JoeShi/ki-board/docs/ESP32_5SCREEN_V0.1.pdf

## J111.25_9P

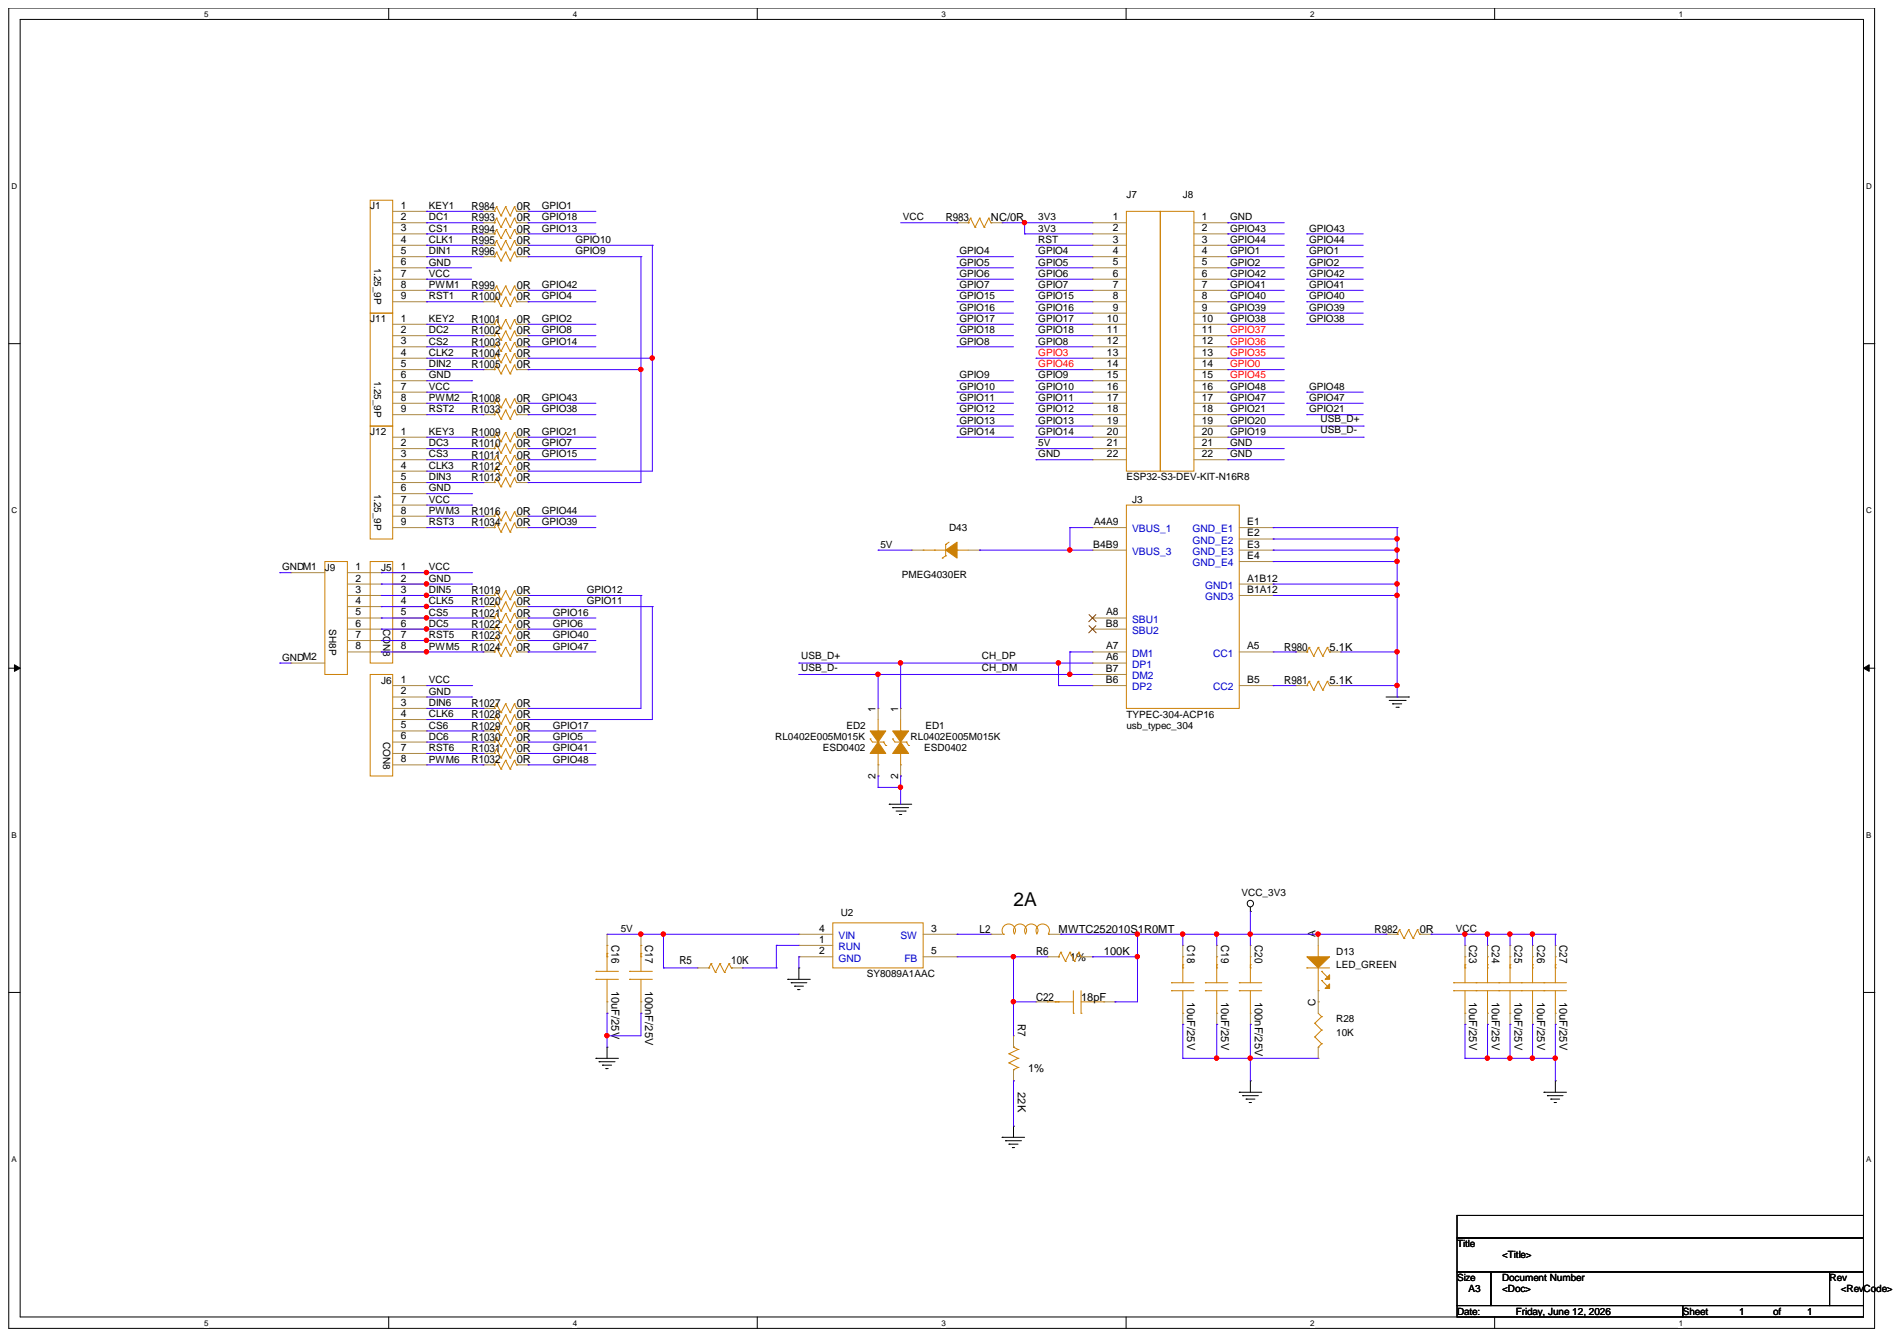
[picture p1: page 1]
