JoeShi/ki-board/(commit log)

2026-06-09 Initial commit: Kiro shortcut keyboard firmware
    ESP32-C6 BLE HID keyboard with 4 screen-keys, rotary encoder, and web config.
    - Modules: keymap/buttons/encoder/ble_hid/display/webconfig
    - BLE HID via HijelHID_BLEKeyboard (NimBLE), encoder via RotaryEncoderPCNT
    - Display via Arduino_GFX (ST7735), web config via ESPAsyncWebServer + NVS
    - Includes docs (hardware bring-up guide, tech glossary) and steering notes
    [default_16MB.csv]
2026-06-09 Add PWM backlight dimming for displays
    - BL pin (GPIO3) driven via LEDC PWM instead of on/off, reduces power and eye strain
    - displaySetBacklight/displayGetBacklight API, configurable freq/resolution/default in config.h
2026-06-13 切换至 USB HID + 圆屏表情动画系统
    通信方案
    - 从 BLE HID 切换为 USB HID (Arduino 内置 USB.h + USBHIDKeyboard.h)
    - 更可靠地触发 macOS 语音输入(双击 Control)等系统级快捷键
    - BLE 代码(ble_hid.*)保留为备用方案
    - 文档对齐: README / design-decisions / project-overview / 硬件调试指南
    圆屏表情
    - 新增 idle / wait / work 三套表情, 各 40 帧 RGB565 @ 4fps, 120x120
    - 圆屏(GC9D01)居中播放, 白色内容显示在黑底上
    - scripts/generate_expressions.py 固化生成管线(ffmpeg 裁切 + region-aware 处理)
    其他
    - 分区表 default_16MB.csv 扩大 app 分区至 8MB(移除 OTA)以容纳表情数据
    - .gitignore 忽略表情中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
    [default_16MB.csv]
2026-06-13 Update firmware display wiring and docs
2026-06-13 Fix ESP32-S3 board target and LCD test
    [test_round_lcd.cpp]
2026-06-13 Add Kiro agent board integration
2026-06-13 Refine agent keyboard interaction flow
2026-06-16 feat: add USB auto-discovery to kiro_board_hook.py and custom USB descriptors
    - Add discover_serial_port() function that matches VID=0x303A, PID=0x1001,
    and product string containing 'ki-board' (case-insensitive)
    - Implement port resolution priority chain:
    1. --serial-port CLI arg
    2. KIRO_BOARD_PORT environment variable
    3. Auto-discovery via serial.tools.list_ports
    4. Fallback to stdout
    - Print diagnostic message to stderr when auto-discovery finds a port
    - Add -DUSB_PRODUCT and -DUSB_MANUFACTURER build flags to [env:esp32-s3]
    so the ESP32-S3 USB CDC reports as 'ki-board' by 'Kiro'
2026-06-16 docs: update documentation to reflect zero-config USB auto-discovery
    - Remove --serial-port from docs/kiro-cli-hooks.example.json
    - Add section 8.3 '自动发现串口' to kiro-agent-status-sync.md
    - Update command examples in sections 6, 7 to show zero-config usage
    - Update AGENTS.md hook integration section with auto-discovery info
    - Update README.md hook configuration section for zero-config
2026-06-16 fix: add multi-board warning and pyserial import hint in discover_serial_port()
    Address review feedback:
    - Issue #1: Emit stderr warning when multiple ki-board devices are found
    - Issue #2: Print diagnostic hint when pyserial import fails instead of
    silently returning None
    [kiro_board_hook.py]
2026-06-20 feat: companion app + USB/BLE pairing & board GATT comms
    Companion (Tauri):
    - USB CDC + BLE GATT bridge to the board, Doubao voice console, keymap editor, firmware flash.
    - Device page redesign: pick USB (plug-and-play) or Bluetooth; pairing only under Bluetooth, auto-connects the bound board (no manual device picking).
    - Application-level pairing/auth: token stored in OS keychain; auth sent on BLE connect; Pair/Forget flow with on-board numeric-comparison confirm.
    - Fix: keep BLE Manager/Adapter alive for the connection lifetime so CoreBluetooth notifications are delivered; truthful write logging; 5s heartbeat; suppress heartbeat log spam.
    Firmware:
    - Custom Kiro BLE GATT service with per-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
    [agent_registry.cpp, agent_registry.h, ble_gatt_comm.cpp, ble_gatt_comm.h, kiro_board_hook.py]
2026-06-20 feat: NimBLE migration, BLE HID keyboard, HID output routing via companion
    - Migrated custom Kiro GATT service from Bluedroid to NimBLE (shared server singleton).
    - Added BLE HID keyboard (HijelHID_BLEKeyboard) on the same NimBLE server.
    - HID only discoverable during pairing mode (left+right 3s); hidden otherwise.
    - Pairing confirm (●) now always exits pairing window even without companion request.
    - HID output routing: companion app configures USB or BLE HID via set_hid_output command; board persists choice in NVS.
    - Device page: mode switch syncs HID output to board; pairing code shown inline via status polling.
    - Added clear_logs command and Clear button in Event Log.
2026-06-20 feat: voice engine selection (system/doubao), fix ASR endpoint & audio buffering
    [agent_registry.cpp, agent_registry.h, main.cpp]
2026-06-20 fix: stabilize doubao voice controls
    [agent_registry.cpp, agent_registry.h, main.cpp]
2026-06-21 feat: add BLE OTA manager + companion ota_flash example + UI/pairing updates
    [default_16MB.csv]
2026-06-21 refactor: remove connection_mode config, hardcode USB-first BLE-fallback
    - Remove connection_mode from Settings (backend + frontend)
    - Simplify connect_device_inner: always try USB first, fall back to BLE
    - Auto-sync HID output based on actual transport kind after connect
    - Merge USB/BLE panels into unified Device Bridge UI
    - Show DISCONNECTED in LINK LCD when offline
2026-06-21 feat: auto-connect, channel locking, status bar, and UX improvements
    Companion App:
    - Remove connection_mode config; hardcode USB-first BLE-fallback
    - Auto-connect on startup and auto-reconnect after disconnect
    - Connection manager with heartbeat (3 missed pongs = disconnect)
    - Remove Recovery Flash (CH340) from UI; OTA uses current channel
    - Remove keychain dependency for API key; store in settings file
    - BLE scan: drop service UUID filter to find already-connected devices
    - Unified Device Bridge panel; show DISCONNECTED in LINK LCD
    - Active channel locking: hello locks USB/BLE, events sent only to active
    - hello_ack and pong include channel field
    - Device status bar: version, un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
    [agent_registry.cpp, agent_registry.h, ble_gatt_comm.cpp, ble_gatt_comm.h, main.cpp, ota_manager.cpp]
2026-06-21 fix: reduce rect LCD flicker by clearing tiles individually instead of full fillScreen
    [ui_render.cpp]
2026-06-30 feat: add powershell_shim to suppress hook popup windows on Windows Kiro CLI's TUI spawns hooks with CREATE_NEW_CONSOLE, causing a visible console window flash for every hook execution on Windows. Th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
2026-07-01 fix: add Windows platform support to kiro_board_hook.py The emit_line() function previously used fcntl (Unix-only) for serial port locking, which crashes on Windows with ImportError. This adds platfo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
    [kiro_board_hook.py]
